jneaton922/UnwaryNuc/UnwaryNuc.kicad_pcb

## KiCad design UnwaryNuc.kicad_pcb (2021-09-27)

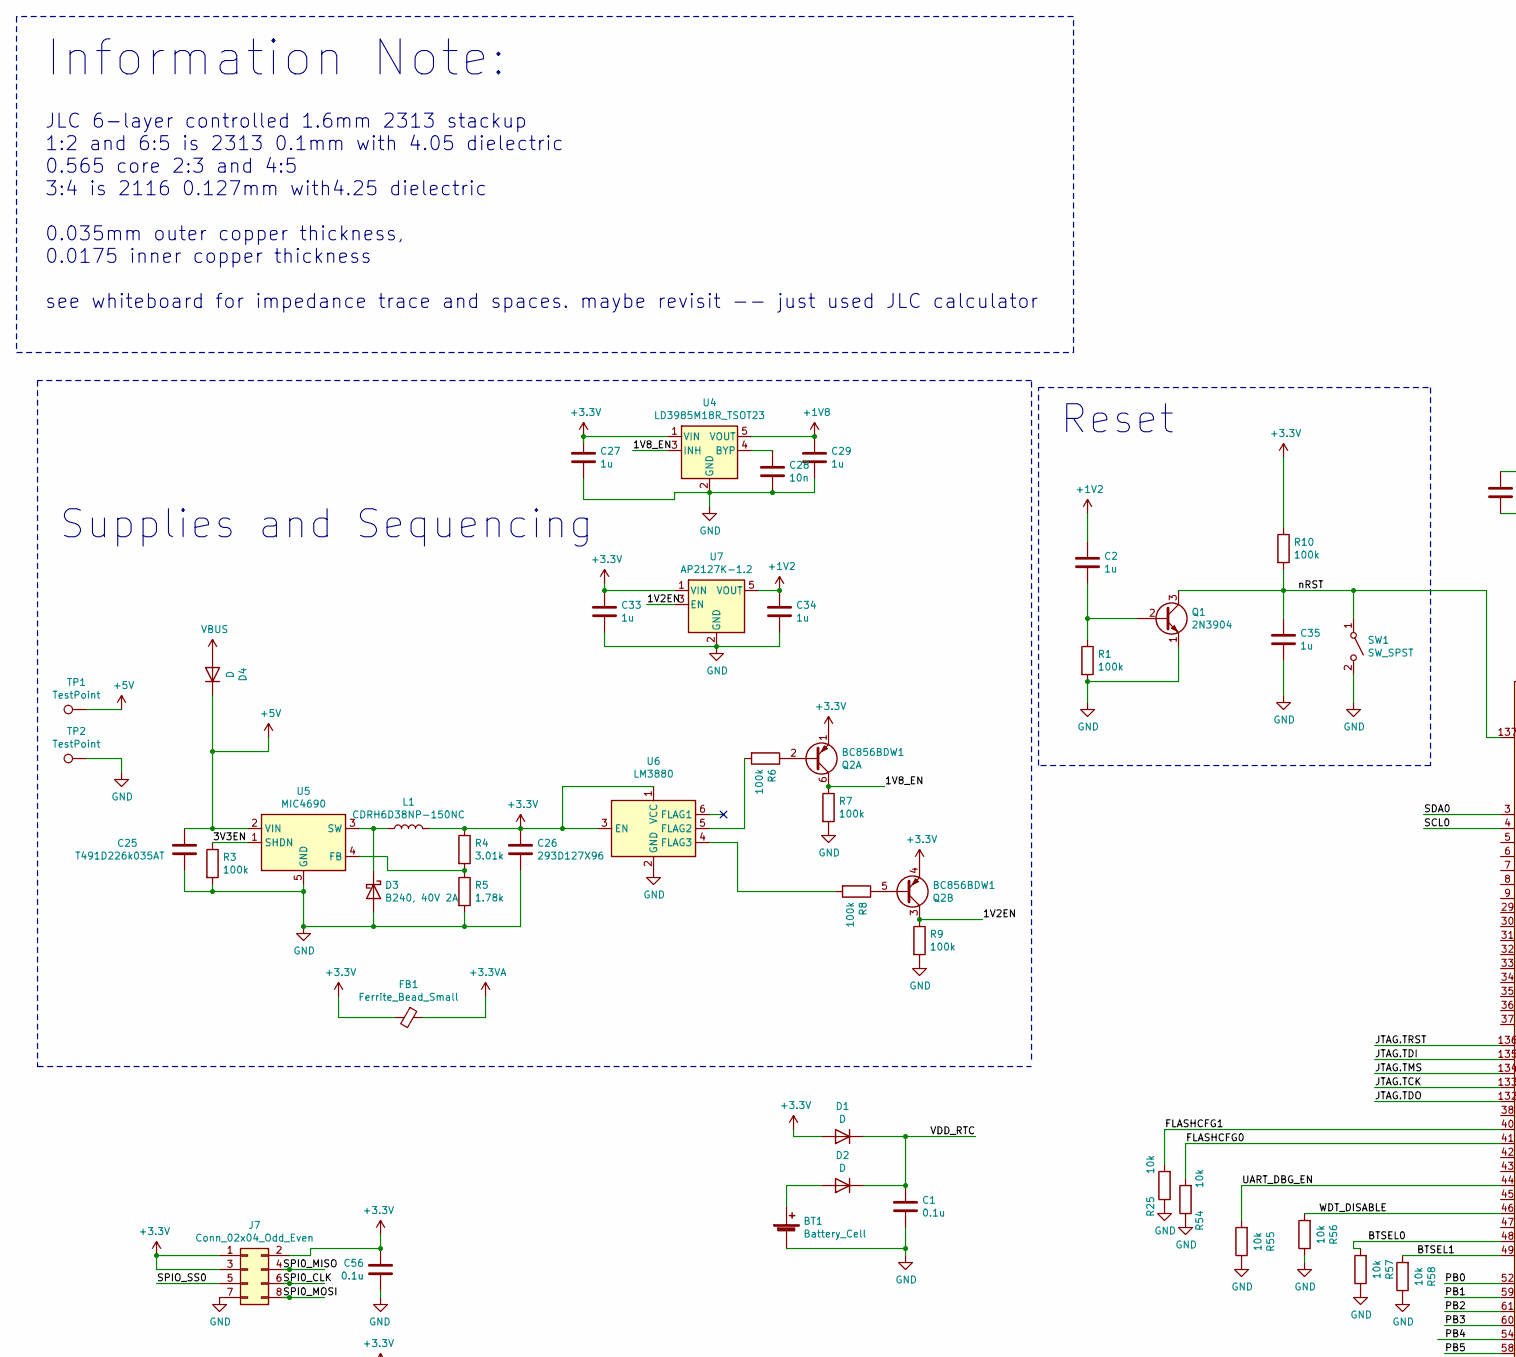
[picture p1: schematic UnwaryNuc.sch, part in row 1, column 1]

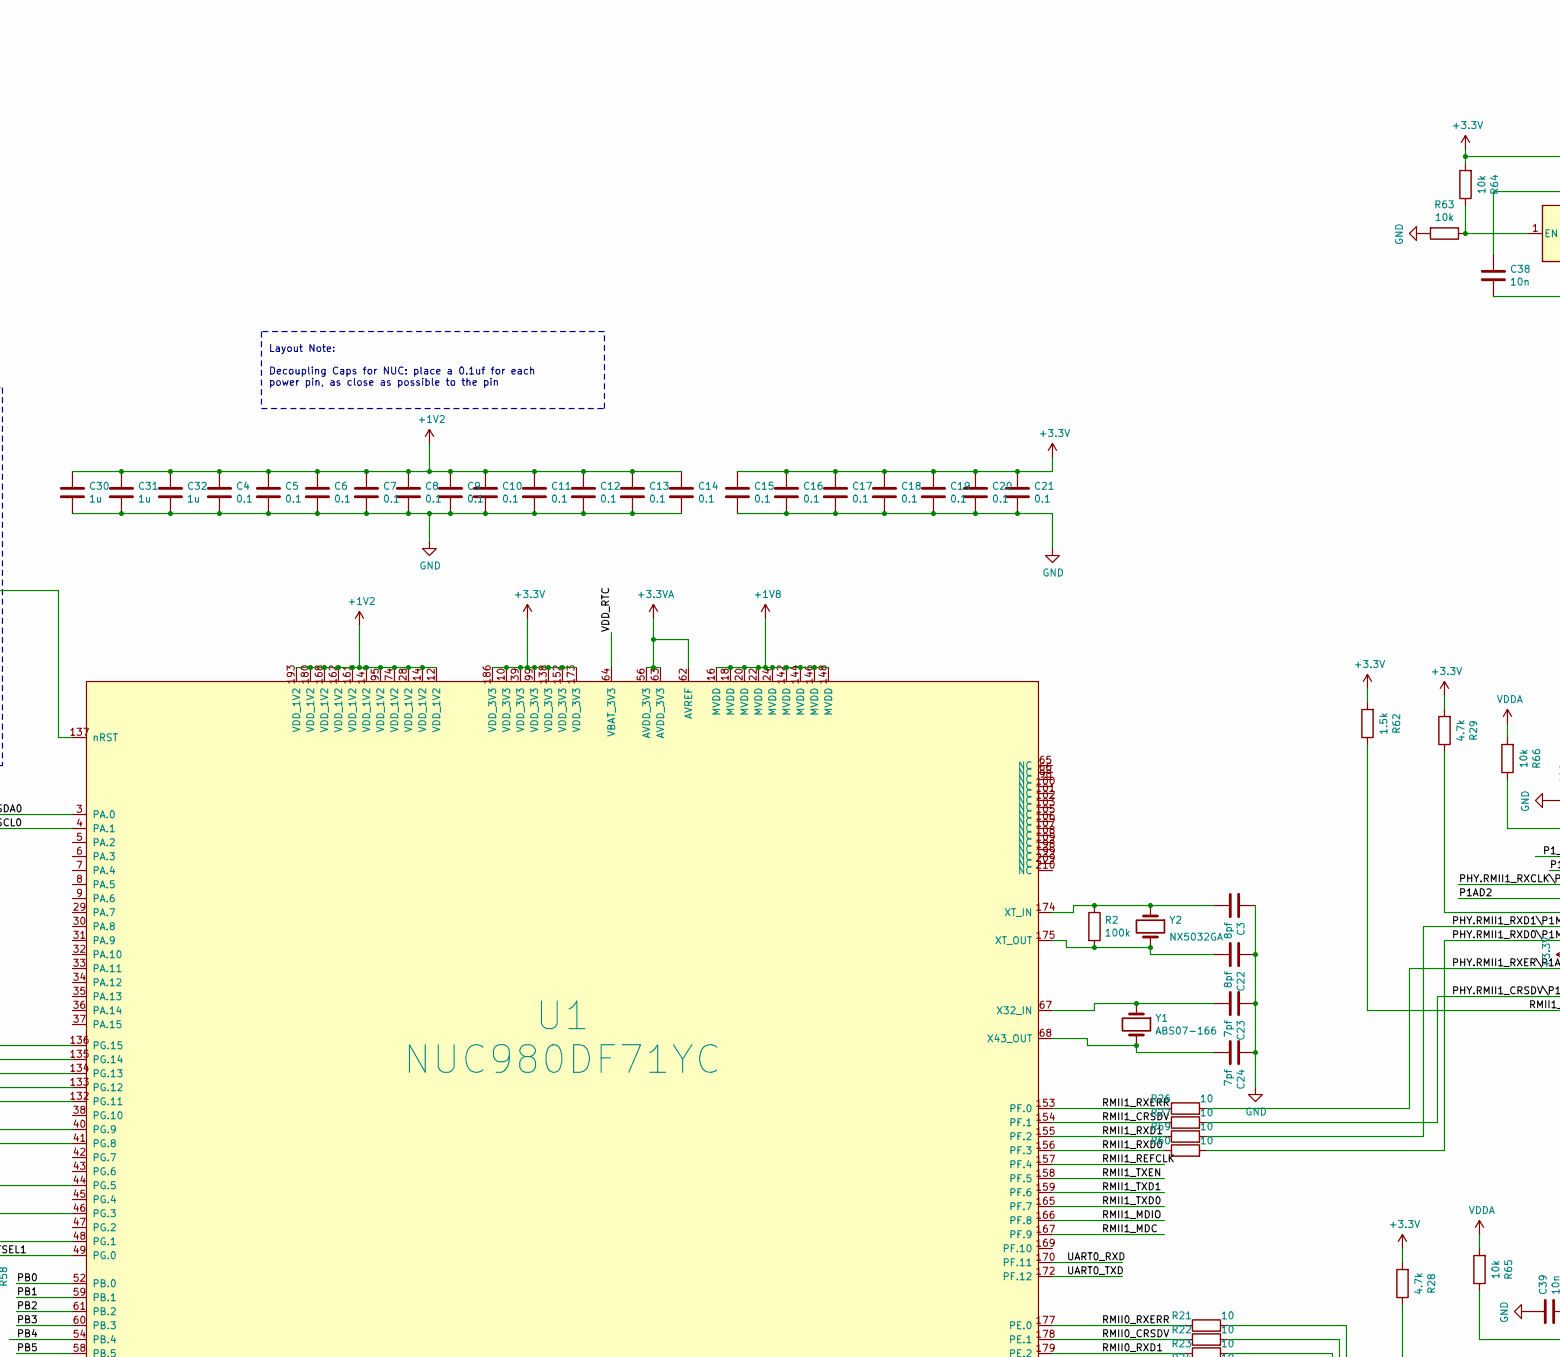
[picture p2: schematic UnwaryNuc.sch, part in row 1, column 2]

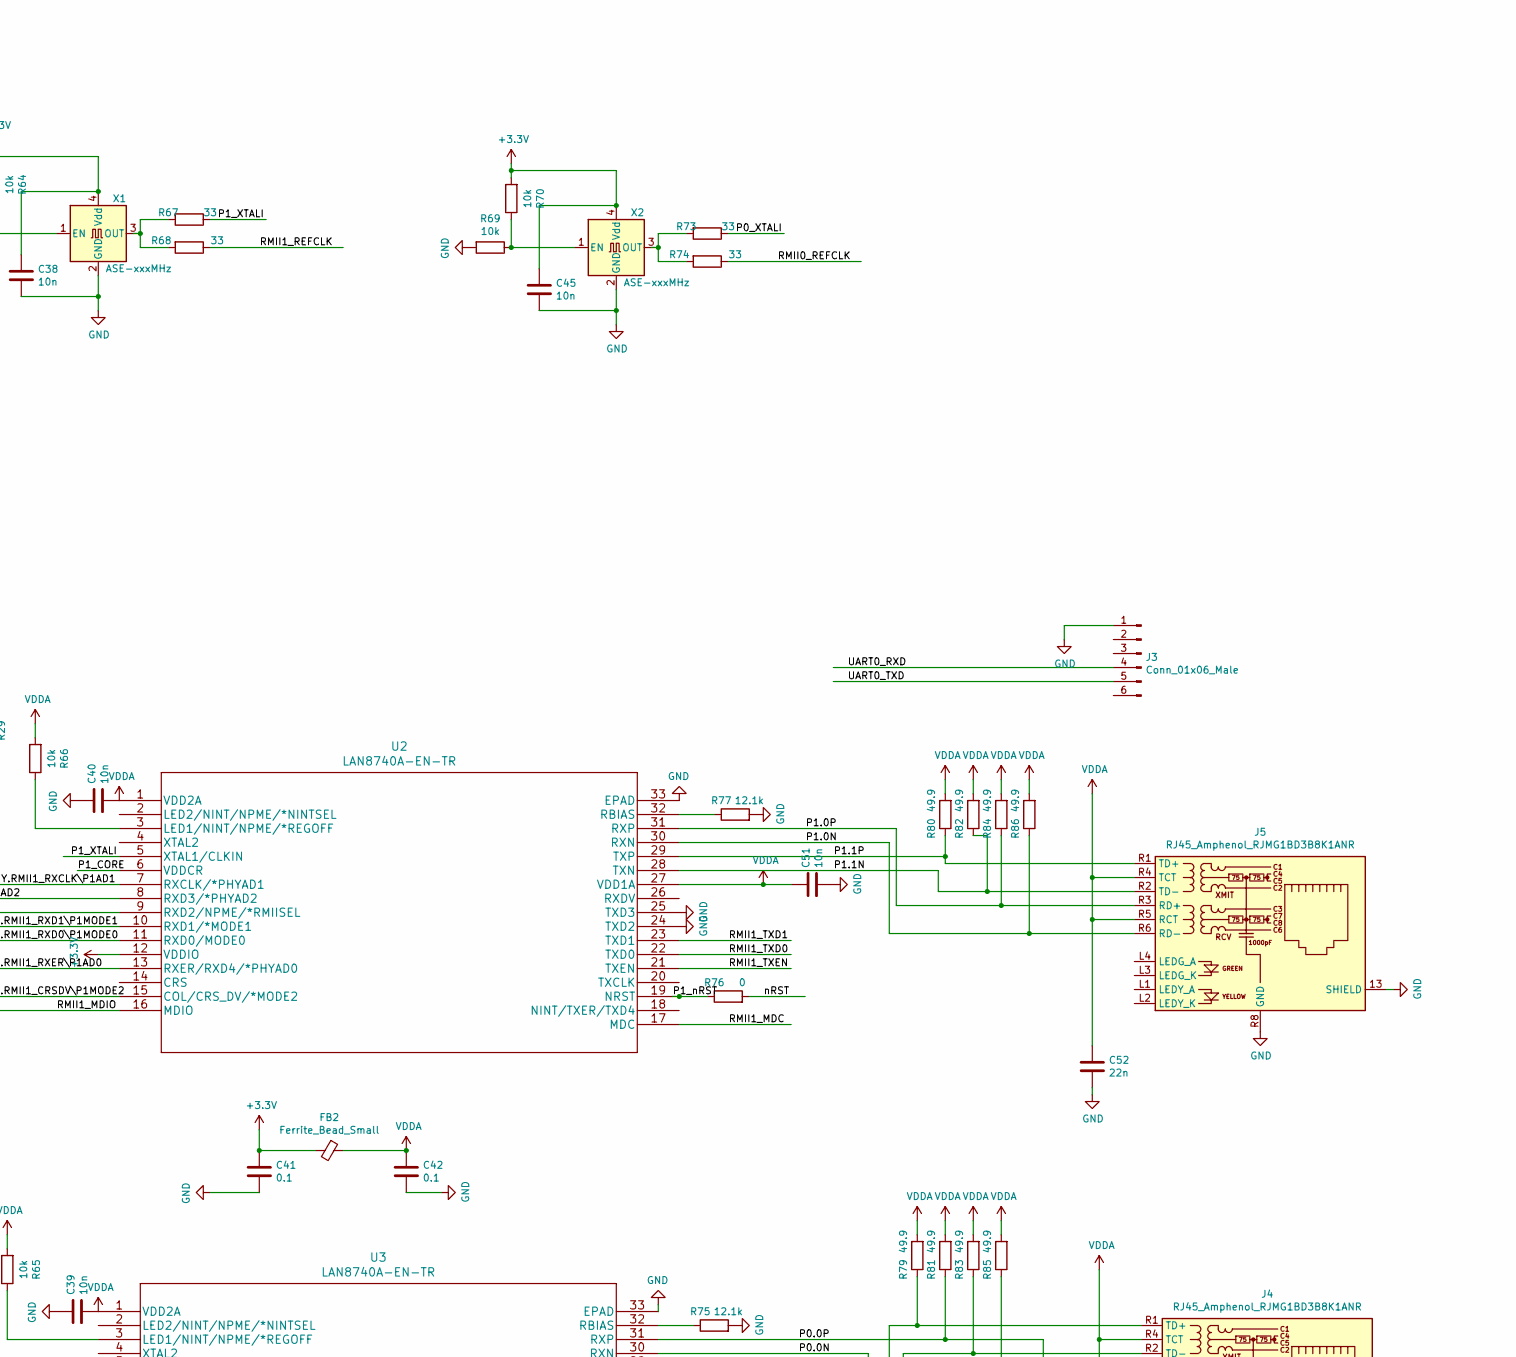
[picture p3: schematic UnwaryNuc.sch, part in row 1, column 3]

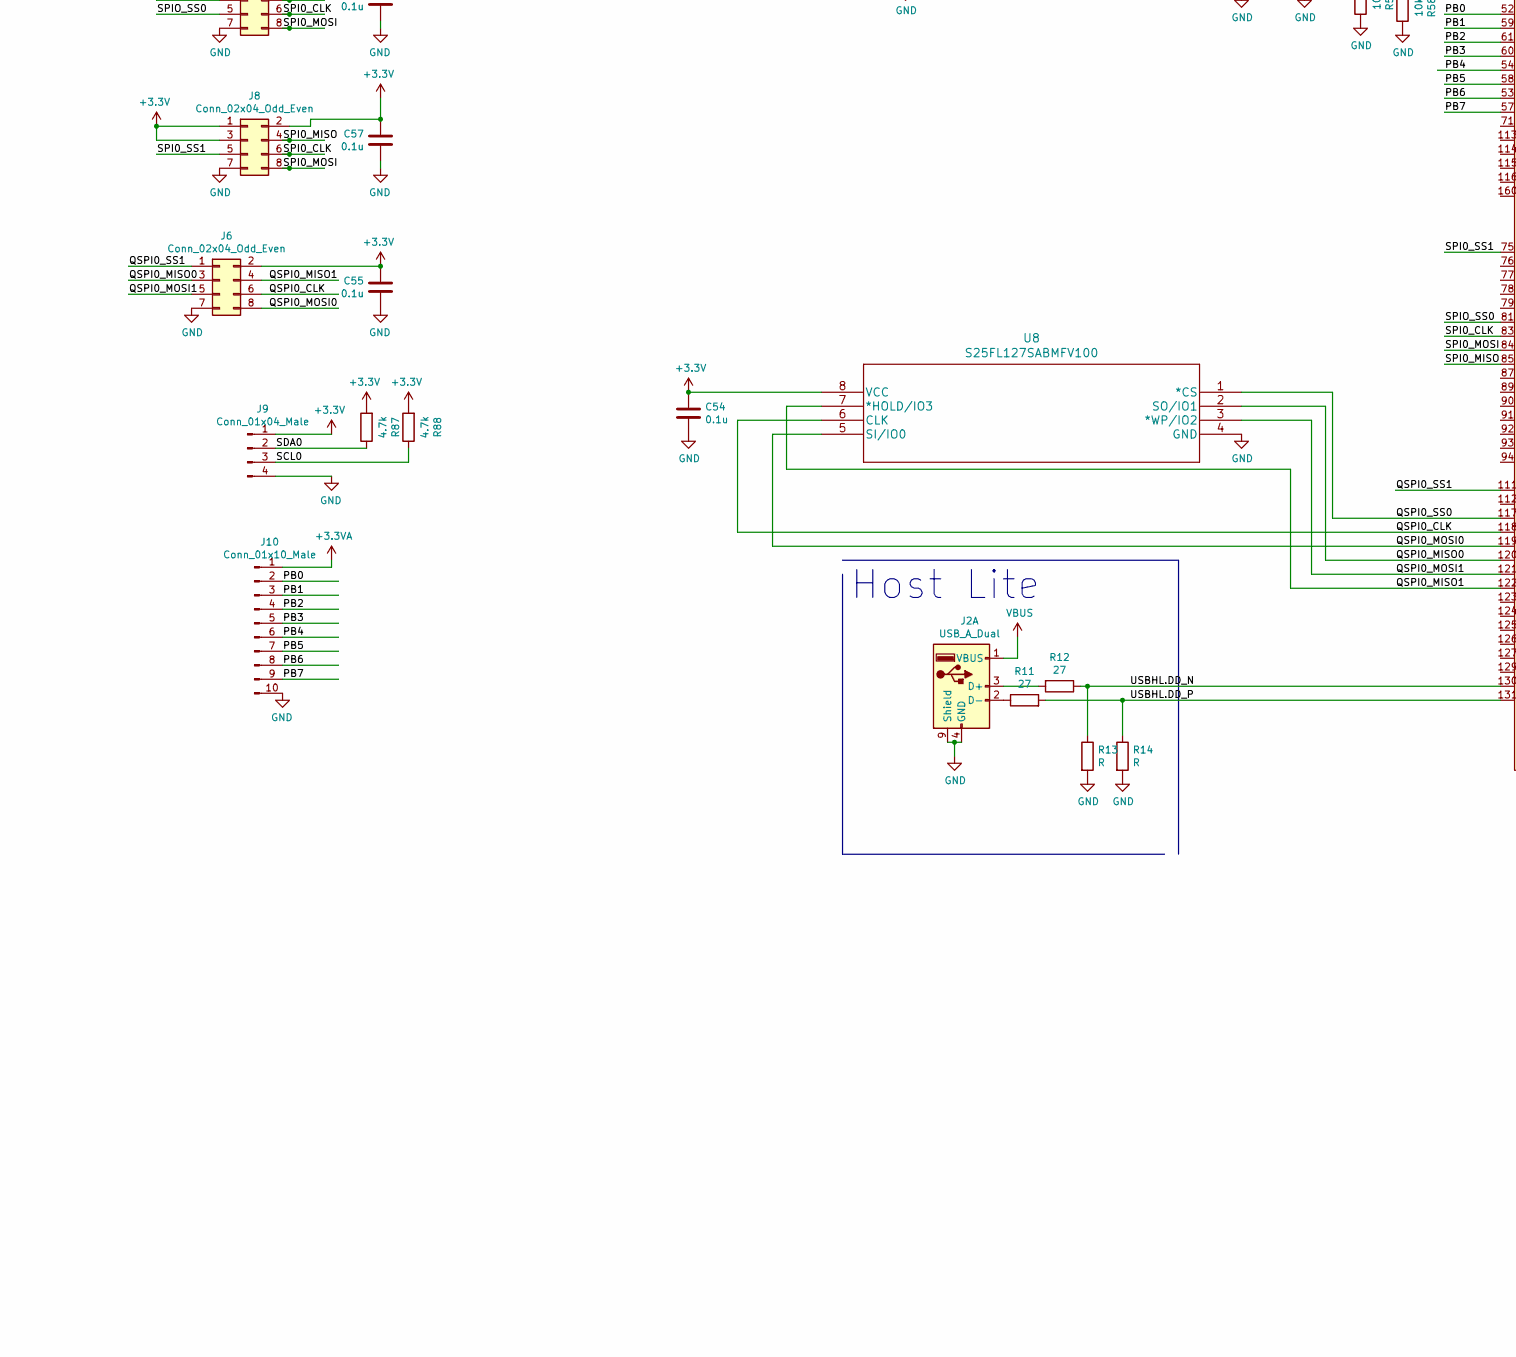
[picture p4: schematic UnwaryNuc.sch, part in row 2, column 1]

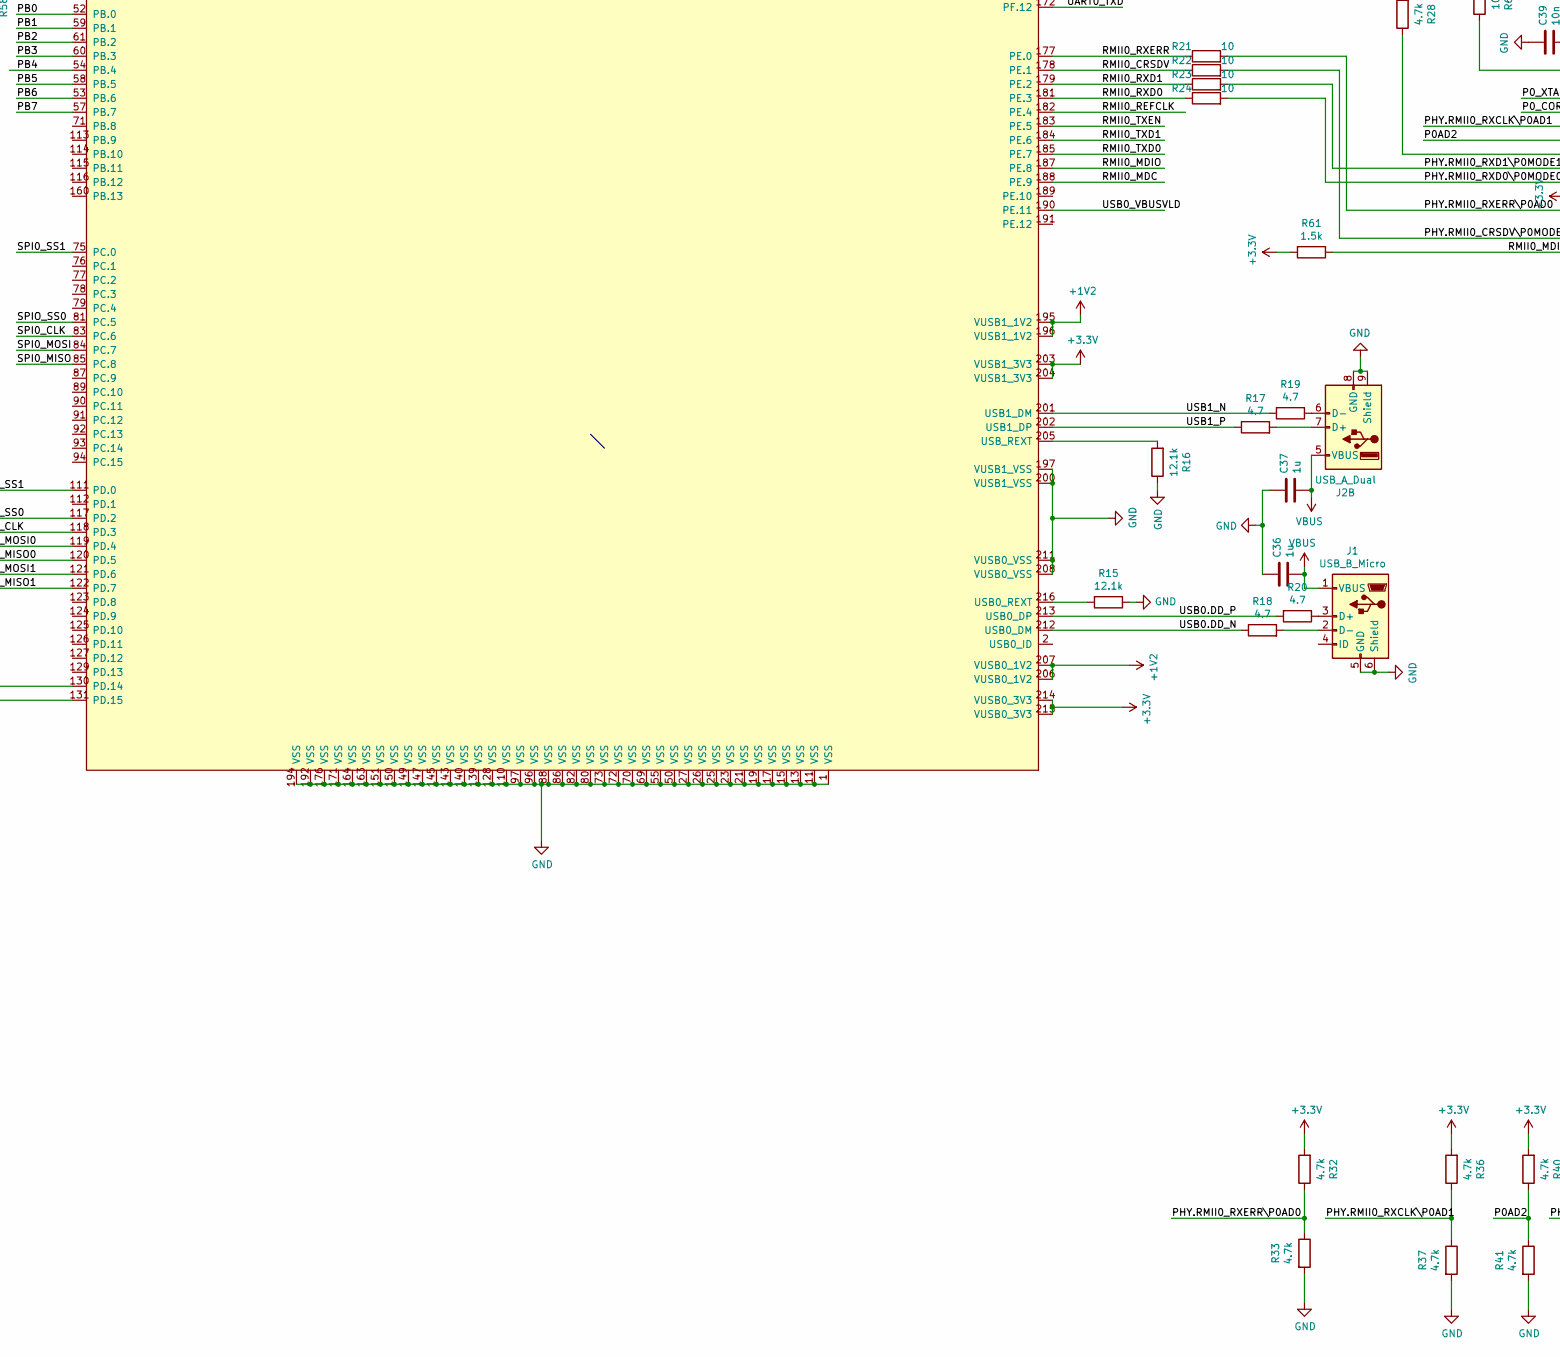
[picture p5: schematic UnwaryNuc.sch, part in row 2, column 2]

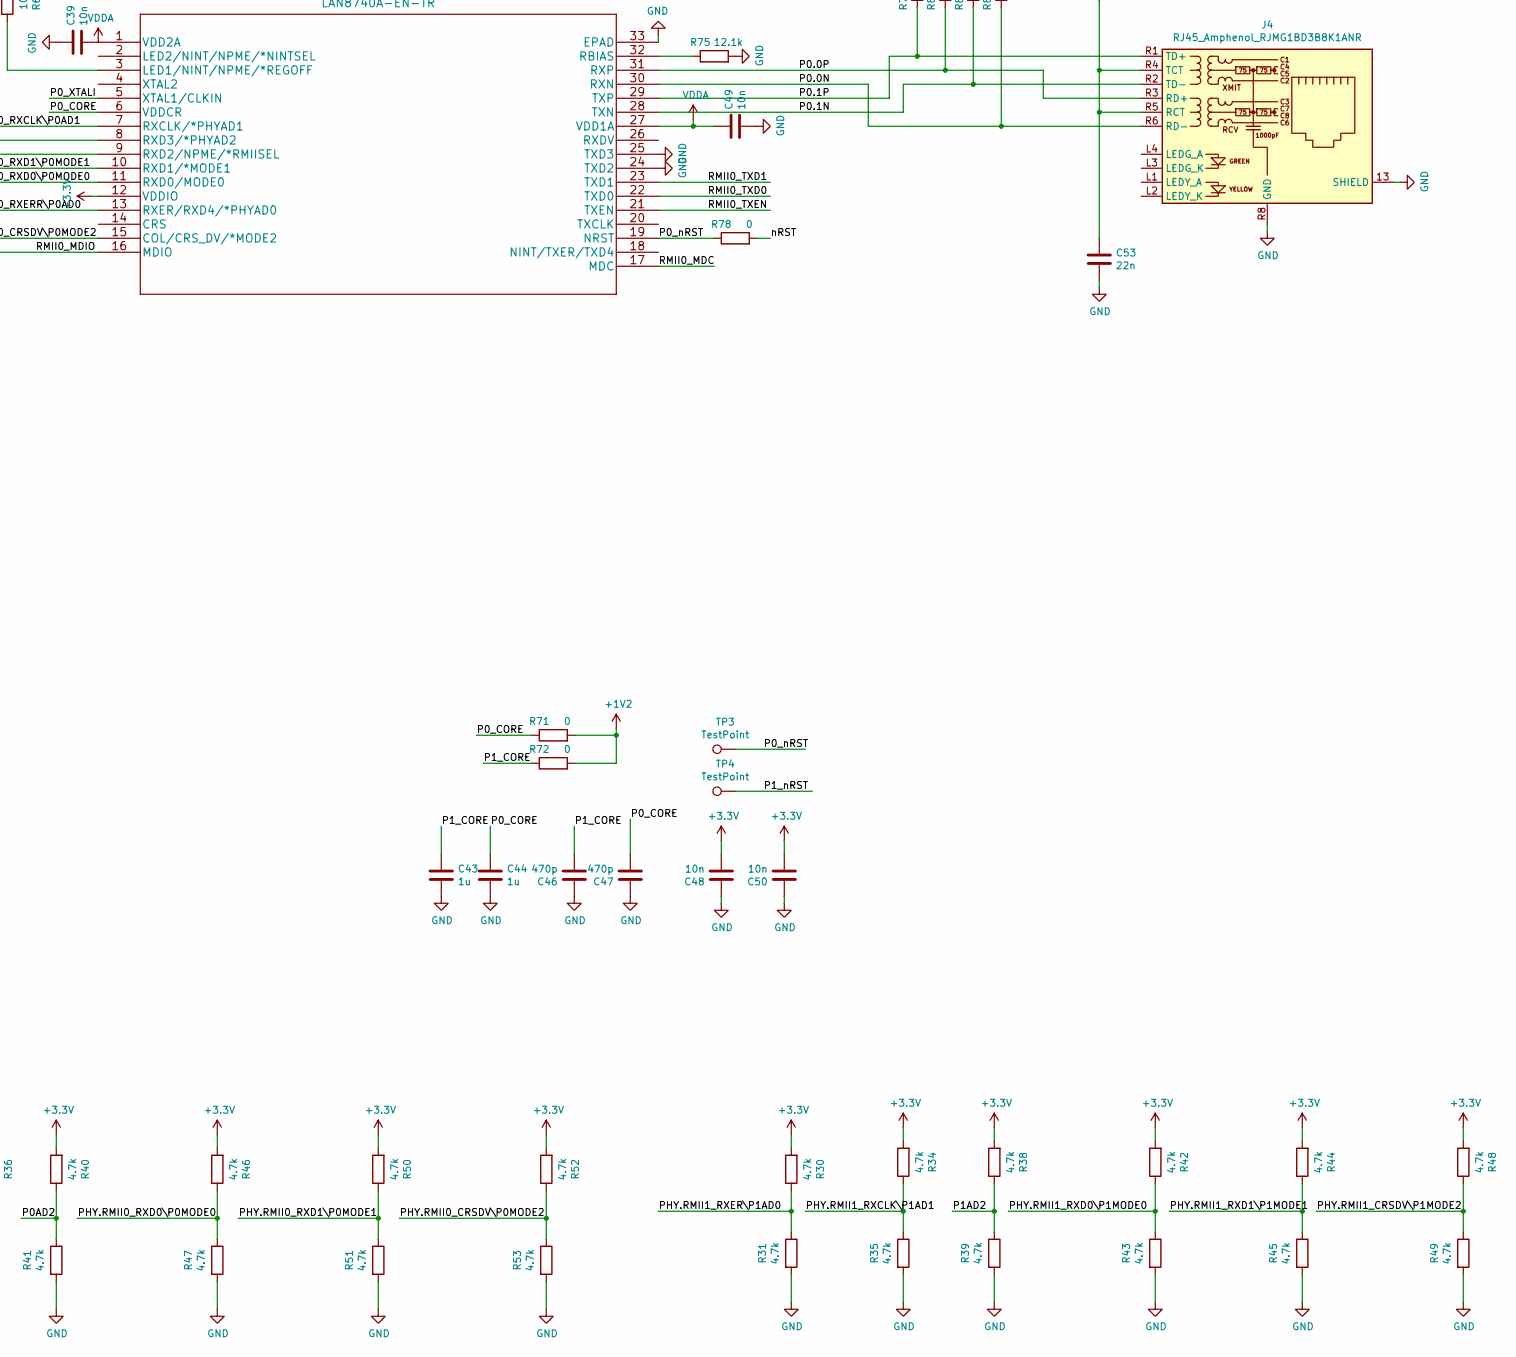
[picture p6: schematic UnwaryNuc.sch, part in row 2, column 3]

Parts:
BT1: Battery_Cell; Battery_Panasonic_CR2032-VS1N_Vertical_CircularHoles
C1, C54, C55, C56, C57: 0.1u; C_1206_3216Metric_Pad1.33x1.80mm_HandSolder
C2, C27, C29, C30, C31, C32, C33, C34, C35, C36, C37, C43, C44: 1u; C_1206_3216Metric_Pad1.33x1.80mm_HandSolder
C3, C22: 8pf; C_0603_1608Metric_Pad1.08x0.95mm_HandSolder
C4, C5, C6, C7, C8, C9, C10, C11, C12, C13, C14, C15, C16, C17, C18, C19, C20, C21, C41, C42: 0.1; C_1206_3216Metric_Pad1.33x1.80mm_HandSolder
C23, C24: 7pf; C_0603_1608Metric_Pad1.08x0.95mm_HandSolder
C25: T491D226k035AT; CP_EIA-7343-15_Kemet-W_Pad2.25x2.55mm_HandSolder
C26: 293D127X96; CP_EIA-7343-43_Kemet-X_Pad2.25x2.55mm_HandSolder
C28: 10n; C_1206_3216Metric_Pad1.33x1.80mm_HandSolder
C38, C39, C40, C45, C48, C49, C50, C51: 10n; C_0603_1608Metric_Pad1.08x0.95mm_HandSolder
C46, C47: 470p; C_0603_1608Metric_Pad1.08x0.95mm_HandSolder
C52, C53: 22n; C_0805_2012Metric_Pad1.18x1.45mm_HandSolder
D1, D2, D4: D; D_SOD-523
D3: B240, 40V 2A; D_SMB_Handsoldering
FB1, FB2: Ferrite_Bead_Small; L_1206_3216Metric_Pad1.42x1.75mm_HandSolder
J1: USB_B_Micro; USB_Micro-B_Molex_47346-0001
J2: USB_A_Dual; USB_A_Wuerth_61400826021_Horizontal_Stacked
J3: Conn_01x06_Male; PinHeader_1x06_P2.54mm_Vertical
J4, J5: RJ45_Amphenol_RJMG1BD3B8K1ANR
J6, J7, J8: Conn_02x04_Odd_Even; PinHeader_2x04_P2.54mm_Vertical
J9: Conn_01x04_Male; PinHeader_1x04_P2.54mm_Vertical
J10: Conn_01x10_Male; PinHeader_1x10_P2.54mm_Vertical
L1: CDRH6D38NP-150NC; CDRH6D38_Sumida
Q1: 2N3904; TO-92_Inline
Q2: BC856BDW1; SOT-363_SC-70-6
R1, R2, R3, R6, R7, R8, R9, R10: 100k; R_0805_2012Metric_Pad1.20x1.40mm_HandSolder
R4: 3.01k; R_0805_2012Metric_Pad1.20x1.40mm_HandSolder
R5: 1.78k; R_0805_2012Metric_Pad1.20x1.40mm_HandSolder
R11, R12: 27; R_0603_1608Metric_Pad0.98x0.95mm_HandSolder
R13, R14: R; R_0603_1608Metric_Pad0.98x0.95mm_HandSolder
R15, R16, R75, R77: 12.1k; R_0603_1608Metric_Pad0.98x0.95mm_HandSolder
R17, R18, R19, R20: 4.7; R_0603_1608Metric_Pad0.98x0.95mm_HandSolder
R21, R22, R23, R24, R26, R27, R59, R60: 10; R_0603_1608Metric_Pad0.98x0.95mm_HandSolder
R25, R54, R55, R56, R57, R58, R63, R64, R65, R66, R69, R70: 10k; R_0603_1608Metric_Pad0.98x0.95mm_HandSolder
R28, R29, R30, R31, R32, R33, R34, R35, R36, R37, R38, R39, R40, R41, R42, R43, R44, R45, R46, R47, R48, R49, R50, R51, R52, R53, R87, R88: 4.7k; R_0603_1608Metric_Pad0.98x0.95mm_HandSolder
R61, R62: 1.5k; R_0603_1608Metric_Pad0.98x0.95mm_HandSolder
R67, R68, R73, R74: 33; R_0603_1608Metric_Pad0.98x0.95mm_HandSolder
R71, R72: 0; R_0805_2012Metric_Pad1.20x1.40mm_HandSolder
R76, R78: 0; R_0603_1608Metric_Pad0.98x0.95mm_HandSolder
R79, R80, R81, R82, R83, R84, R85, R86: 49.9; R_0603_1608Metric_Pad0.98x0.95mm_HandSolder
SW1: SW_SPST; SW_SPST_CK_RS282G05A3
TP1, TP2, TP3, TP4: TestPoint; TestPoint_Keystone_5019_Minature
U1: NUC980DF71YC
U2, U3: LAN8740A-EN-TR
U4: LD3985M18R_TSOT23; TSOT-23-5_HandSoldering
U5: MIC4690; SOIC-8_3.9x4.9mm_P1.27mm
U6: LM3880; SOT-23-6
U7: AP2127K-1.2; SOT-23-5
U8: S25FL127SABMFV100
X1, X2: ASE-xxxMHz; Oscillator_SMD_Abracon_ASE-4Pin_3.2x2.5mm
Y1: ABS07-166; Crystal_SMD_3215-2Pin_3.2x1.5mm
Y2: NX5032GA; Crystal_SMD_5032-2Pin_5.0x3.2mm_HandSoldering

Connections:
+1V2: C2.1, C4.1, C5.1, C6.1, C7.1, C8.1, C9.1, C10.1, C11.1, C12.1, C13.1, C14.1, C30.1, C31.1, C32.1, C34.1, R71.2, R72.2, U1.12 (VDD_1V2), U1.14 (VDD_1V2), U1.28 (VDD_1V2), U1.74 (VDD_1V2), U1.95 (VDD_1V2), U1.141 (VDD_1V2), U1.161 (VDD_1V2), U1.162 (VDD_1V2), U1.168 (VDD_1V2), U1.180 (VDD_1V2), U1.193 (VDD_1V2), U1.195 (VUSB1_1V2), U1.196 (VUSB1_1V2), U1.206 (VUSB0_1V2), U1.207 (VUSB0_1V2), U7.5 (VOUT)
+1V8: C29.1, U1.16 (MVDD), U1.18 (MVDD), U1.20 (MVDD), U1.22 (MVDD), U1.24 (MVDD), U1.142 (MVDD), U1.144 (MVDD), U1.146 (MVDD), U1.148 (MVDD), U4.5 (VOUT)
+3.3VA: FB1.1, J10.1, U1.56 (AVDD_3V3), U1.62 (AVREF), U1.63 (AVDD_3V3)
+3V3: C15.1, C16.1, C17.1, C18.1, C19.1, C20.1, C21.1, C26.1, C27.1, C33.1, C38.1, C41.1, C45.1, C48.2, C50.2, C54.1, C55.1, C56.1, C57.1, D1.2 (A), FB1.2, FB2.2, J6.2, J7.1, J7.2, J7.3, J8.1, J8.2, J8.3, J9.1, L1.2, Q2.1 (E1), Q2.4 (E2), R4.1, R10.1, R28.2, R29.2, R30.2, R32.2, R34.2, R36.2, R38.2, R40.2, R42.2, R44.2, R46.2, R48.2, R50.2, R52.2, R61.2, R62.2, R64.2, R70.2, R87.2, R88.2, U1.10 (VDD_3V3), U1.39 (VDD_3V3), U1.99 (VDD_3V3), U1.138 (VDD_3V3), U1.152 (VDD_3V3), U1.173 (VDD_3V3), U1.186 (VDD_3V3), U1.203 (VUSB1_3V3), U1.204 (VUSB1_3V3), U1.214 (VUSB0_3V3), U1.215 (VUSB0_3V3), U2.12 (VDDIO), U3.12 (VDDIO), U4.1 (VIN), U6.1 (VCC), U6.3 (EN), U7.1 (VIN), U8.8 (VCC), X1.4 (Vdd), X2.4 (Vdd)
+5V: C25.1, D4.1 (K), TP1.1, U5.2 (VIN)
/1V2EN: Q2.3 (C2), R9.1, U7.3 (EN)
/1V8_EN: Q2.6 (C1), R7.1, U4.3 (INH)
/3V3EN: R3.1, U5.1 (SHDN)
/BTSEL0: R57.2, U1.48 (PG.1)
/BTSEL1: R58.2, U1.49 (PG.0)
/FLASHCFG0: R54.2, U1.41 (PG.8)
/FLASHCFG1: R25.2, U1.40 (PG.9)
/JTAG.TCK: U1.133 (PG.12)
/JTAG.TDI: U1.135 (PG.14)
/JTAG.TDO: U1.132 (PG.11)
/JTAG.TMS: U1.134 (PG.13)
/JTAG.TRST: U1.136 (PG.15)
/P0.0N: J4.R6 (RD-), R85.1, U3.30 (RXN)
/P0.0P: J4.R3 (RD+), R81.1, U3.31 (RXP)
/P0.1N: J4.R2 (TD-), R83.1, U3.28 (TXN)
/P0.1P: J4.R1 (TD+), R79.1, U3.29 (TXP)
/P0AD2: R40.1, R41.1, U3.8 (RXD3/*PHYAD2)
/P0_CORE: C44.1, C47.2, R71.1, U3.6 (VDDCR)
/P0_XTALI: R73.1, U3.5 (XTAL1/CLKIN)
/P0_nRST: R78.1, TP3.1, U3.19 (NRST)
/P1.0N: J5.R6 (RD-), R86.1, U2.30 (RXN)
/P1.0P: J5.R3 (RD+), R84.1, U2.31 (RXP)
/P1.1N: J5.R2 (TD-), R82.1, U2.28 (TXN)
/P1.1P: J5.R1 (TD+), R80.1, U2.29 (TXP)
/P1AD2: R38.1, R39.1, U2.8 (RXD3/*PHYAD2)
/P1_CORE: C43.1, C46.2, R72.1, U2.6 (VDDCR)
/P1_XTALI: R67.1, U2.5 (XTAL1/CLKIN)
/P1_nRST: R76.1, TP4.1, U2.19 (NRST)
/PB0: J10.2, U1.52 (PB.0)
/PB1: J10.3, U1.59 (PB.1)
/PB2: J10.4, U1.61 (PB.2)
/PB3: J10.5, U1.60 (PB.3)
/PB4: J10.6, U1.54 (PB.4)
/PB5: J10.7, U1.58 (PB.5)
/PB6: J10.8, U1.53 (PB.6)
/PB7: J10.9, U1.57 (PB.7)
/PHY.RMII0_CRSDV\P0MODE2: R22.2, R52.1, R53.1, U3.15 (COL/CRS_DV/*MODE2)
/PHY.RMII0_RXCLK\P0AD1: R36.1, R37.1, U3.7 (RXCLK/*PHYAD1)
/PHY.RMII0_RXD0\P0MODE0: R24.2, R46.1, R47.1, U3.11 (RXD0/MODE0)
/PHY.RMII0_RXD1\P0MODE1: R23.2, R50.1, R51.1, U3.10 (RXD1/*MODE1)
/PHY.RMII0_RXERR\P0AD0: R21.2, R32.1, R33.1, U3.13 (RXER/RXD4/*PHYAD0)
/PHY.RMII1_CRSDV\P1MODE2: R27.2, R48.1, R49.1, U2.15 (COL/CRS_DV/*MODE2)
/PHY.RMII1_RXCLK\P1AD1: R34.1, R35.1, U2.7 (RXCLK/*PHYAD1)
/PHY.RMII1_RXD0\P1MODE0: R42.1, R43.1, R60.2, U2.11 (RXD0/MODE0)
/PHY.RMII1_RXD1\P1MODE1: R44.1, R45.1, R59.2, U2.10 (RXD1/*MODE1)
/PHY.RMII1_RXER\P1AD0: R26.2, R30.1, R31.1, U2.13 (RXER/RXD4/*PHYAD0)
/QSPI0_CLK: J6.6, U1.118 (PD.3), U8.6 (CLK)
/QSPI0_MISO0: J6.3, U1.120 (PD.5), U8.2 (SO/IO1)
/QSPI0_MISO1: J6.4, U1.122 (PD.7), U8.7 (*HOLD/IO3)
/QSPI0_MOSI0: J6.8, U1.119 (PD.4), U8.5 (SI/IO0)
/QSPI0_MOSI1: J6.5, U1.121 (PD.6), U8.3 (*WP/IO2)
/QSPI0_SS0: U1.117 (PD.2), U8.1 (*CS)
/QSPI0_SS1: J6.1, U1.111 (PD.0)
/RMII0_CRSDV: R22.1, U1.178 (PE.1)
/RMII0_MDC: U1.188 (PE.9), U3.17 (MDC)
/RMII0_MDIO: R61.1, U1.187 (PE.8), U3.16 (MDIO)
/RMII0_REFCLK: R74.1, U1.182 (PE.4)
/RMII0_RXD0: R24.1, U1.181 (PE.3)
/RMII0_RXD1: R23.1, U1.179 (PE.2)
/RMII0_RXERR: R21.1, U1.177 (PE.0)
/RMII0_TXD0: U1.185 (PE.7), U3.22 (TXD0)
/RMII0_TXD1: U1.184 (PE.6), U3.23 (TXD1)
/RMII0_TXEN: U1.183 (PE.5), U3.21 (TXEN)
/RMII1_CRSDV: R27.1, U1.154 (PF.1)
/RMII1_MDC: U1.167 (PF.9), U2.17 (MDC)
/RMII1_MDIO: R62.1, U1.166 (PF.8), U2.16 (MDIO)
/RMII1_REFCLK: R68.1, U1.157 (PF.4)
/RMII1_RXD0: R60.1, U1.156 (PF.3)
/RMII1_RXD1: R59.1, U1.155 (PF.2)
/RMII1_RXERR: R26.1, U1.153 (PF.0)
/RMII1_TXD0: U1.165 (PF.7), U2.22 (TXD0)
/RMII1_TXD1: U1.159 (PF.6), U2.23 (TXD1)
/RMII1_TXEN: U1.158 (PF.5), U2.21 (TXEN)
/SCL0: J9.3, R88.1, U1.4 (PA.1)
/SDA0: J9.2, R87.1, U1.3 (PA.0)
/SPI0_CLK: J7.6, J8.6, U1.83 (PC.6)
/SPI0_MISO: J7.4, J8.4, U1.85 (PC.8)
/SPI0_MOSI: J7.8, J8.8, U1.84 (PC.7)
/SPI0_SS1: J8.5, U1.75 (PC.0)
/SPIO_SS0: J7.5, U1.81 (PC.5)
/UART0_RXD: J3.4, U1.170 (PF.11)
/UART0_TXD: J3.5, U1.172 (PF.12)
/UART_DBG_EN: R55.2, U1.44 (PG.5)
/USB0.DD_N: R18.1, U1.212 (USB0_DM)
/USB0.DD_P: R20.2, U1.213 (USB0_DP)
/USB0_VBUSVLD: U1.190 (PE.11)
/USB1_N: R19.2, U1.201 (USB1_DM)
/USB1_P: R17.1, U1.202 (USB1_DP)
/USBHL.DD_N: R12.1, R13.1, U1.130 (PD.14)
/USBHL.DD_P: R11.2, R14.1, U1.131 (PD.15)
/VDD_RTC: C1.1, D1.1 (K), D2.1 (K), U1.64 (VBAT_3V3)
/WDT_DISABLE: R56.2, U1.46 (PG.3)
/nRST: C35.1, Q1.3 (C), R10.2, R76.2, R78.2, SW1.1 (A), U1.137 (nRST)
GND: BT1.2 (-), C1.2, C3.1, C4.2, C5.2, C6.2, C7.2, C8.2, C9.2, C10.2, C11.2, C12.2, C13.2, C14.2, C15.2, C16.2, C17.2, C18.2, C19.2, C20.2, C21.2, C22.1, C23.1, C24.1, C25.2, C26.2, C27.2, C28.2, C29.2, C30.2, C31.2, C32.2, C33.2, C34.2, C35.2, C36.1, C37.1, C38.2, C39.1, C40.1, C41.2, C42.2, C43.2, C44.2, C45.2, C46.1, C47.1, C48.1, C49.2, C50.1, C51.2, C52.2, C53.2, C54.2, C55.2, C56.2, C57.2, D3.2 (A), J1.5 (GND), J1.6 (Shield), J2.4 (GND), J2.8 (GND), J2.9 (Shield), J3.1, J4.13 (SHIELD), J4.R8 (GND), J5.13 (SHIELD), J5.R8 (GND), J6.7, J7.7, J8.7, J9.4, J10.10, Q1.1 (E), R1.2, R3.2, R5.2, R7.2, R9.2, R13.2, R14.2, R15.1, R16.1, R25.1, R31.2, R33.2, R35.2, R37.2, R39.2, R41.2, R43.2, R45.2, R47.2, R49.2, R51.2, R53.2, R54.1, R55.1, R56.1, R57.1, R58.1, R63.2, R69.2, R75.2, R77.2, SW1.2 (B), TP2.1, U1.1 (VSS), U1.11 (VSS), U1.13 (VSS), U1.15 (VSS), U1.17 (VSS), U1.19 (VSS), U1.21 (VSS), U1.23 (VSS), U1.25 (VSS), U1.26 (VSS), U1.27 (VSS), U1.50 (VSS), U1.55 (VSS), U1.69 (VSS), U1.70 (VSS), U1.72 (VSS), U1.73 (VSS), U1.80 (VSS), U1.82 (VSS), U1.86 (VSS), U1.88 (VSS), U1.96 (VSS), U1.97 (VSS), U1.110 (VSS), U1.128 (VSS), U1.139 (VSS), U1.140 (VSS), U1.143 (VSS), U1.145 (VSS), U1.147 (VSS), U1.149 (VSS), U1.150 (VSS), U1.151 (VSS), U1.163 (VSS), U1.164 (VSS), U1.171 (VSS), U1.176 (VSS), U1.192 (VSS), U1.194 (VSS), U1.197 (VUSB1_VSS), U1.200 (VUSB1_VSS), U1.208 (VUSB0_VSS), U1.211 (VUSB0_VSS), U2.24 (TXD2), U2.25 (TXD3), U2.33 (EPAD), U3.24 (TXD2), U3.25 (TXD3), U3.33 (EPAD), U4.2 (GND), U5.5 (GND), U5.6 (GND), U5.7 (GND), U5.8 (GND), U6.2 (GND), U7.2 (GND), U8.4 (GND), X1.2 (GND), X2.2 (GND)
unnamed: BT1.1 (+), D2.2 (A)
unnamed: C2.2, Q1.2 (B), R1.1
unnamed: C3.2, R2.1, U1.174 (XT_IN), Y2.1
unnamed: C22.2, R2.2, U1.175 (XT_OUT), Y2.2
unnamed: C23.2, U1.67 (X32_IN), Y1.1
unnamed: C24.2, U1.68 (X43_OUT), Y1.2
unnamed: C28.1, U4.4 (BYP)
unnamed: D3.1 (K), L1.1, U5.3 (SW)
unnamed: J1.2 (D-), R18.2
unnamed: J1.3 (D+), R20.1
unnamed: J2.2 (D-), R11.1
unnamed: J2.3 (D+), R12.2
unnamed: J2.6 (D-), R19.1
unnamed: J2.7 (D+), R17.2
unnamed: Q2.2 (B1), R6.1
unnamed: Q2.5 (B2), R8.1
unnamed: R4.2, R5.1, U5.4 (FB)
unnamed: R6.2, U6.5 (FLAG2)
unnamed: R8.2, U6.4 (FLAG3)
unnamed: R15.2, U1.216 (USB0_REXT)
unnamed: R16.2, U1.205 (USB_REXT)
unnamed: R28.1, U3.9 (RXD2/NPME/*RMIISEL)
unnamed: R29.1, U2.9 (RXD2/NPME/*RMIISEL)
unnamed: R63.1, R64.1, X1.1 (EN)
unnamed: R65.1, U3.3 (LED1/NINT/NPME/*REGOFF)
unnamed: R66.1, U2.3 (LED1/NINT/NPME/*REGOFF)
unnamed: R67.2, R68.2, X1.3 (OUT)
unnamed: R69.1, R70.1, X2.1 (EN)
unnamed: R73.2, R74.2, X2.3 (OUT)
unnamed: R75.1, U3.32 (RBIAS)
unnamed: R77.1, U2.32 (RBIAS)
VBUS: C36.2, C37.2, D4.2 (A), J1.1 (VBUS), J2.1 (VBUS), J2.5 (VBUS)
VDDA: C39.2, C40.2, C42.1, C49.1, C51.1, C52.1, C53.1, FB2.1, J4.R4 (TCT), J4.R5 (RCT), J5.R4 (TCT), J5.R5 (RCT), R65.2, R66.2, R79.2, R80.2, R81.2, R82.2, R83.2, R84.2, R85.2, R86.2, U2.1 (VDD2A), U2.27 (VDD1A), U3.1 (VDD2A), U3.27 (VDD1A)

Notes on the sheet:
Information Note:
JLC 6-layer controlled 1.6mm 2313 stackup 1:2 and 6:5 is 2313 0.1mm with 4.05 dielectric 0.565 core 2:3 and 4:5 3:4 is 2116 0.127mm with4.25 dielectric 0.035mm outer copper thickness, 0.0175 inner copper thickness see whiteboard for impedance trace and spaces. maybe revisit -- just used JLC calcula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
Layout Note: Decoupling Caps for NUC: place a 0.1uf for each power pin, as close as possible to the pin
Reset
Supplies and Sequencing
Host Lite

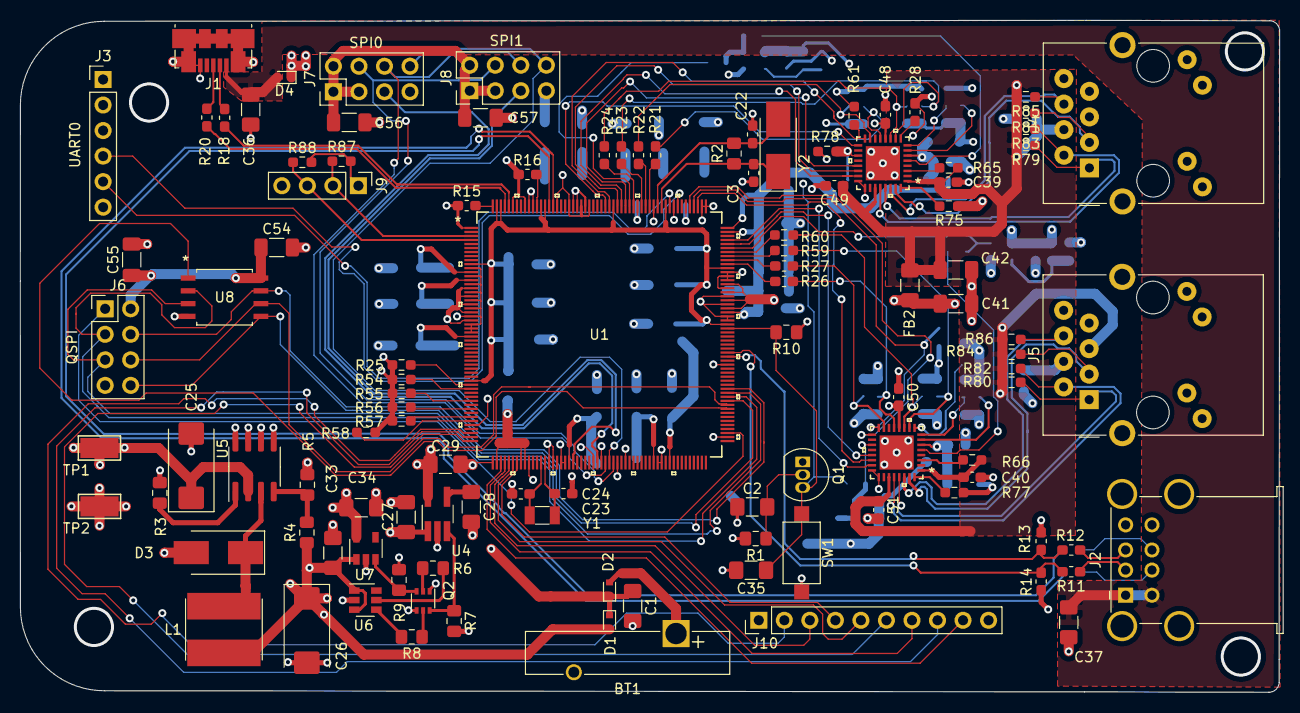
[picture p7: board UnwaryNuc.kicad_pcb from above]

Board: 4 copper layers, 125.3 x 66.8 mm, 182 parts (0 on the bottom side), 126 nets.
