jneaton922/UnwaryNuc/(commit log)

2020-12-30 added some ldos, caps, and reset circuitry.
    [UnwaryNuc.kicad_pcb, UnwaryNuc.sch]
2020-12-31 added supply sequencing and stuff
    [UnwaryNuc.kicad_pcb, UnwaryNuc.sch]
2021-04-28 usb's connected, rmii nets assigned, some placement done
    [UnwaryNuc.kicad_pcb, UnwaryNuc.sch]
2021-06-04 Nuc MAC->PHY->RJ schematic complete, no placement yet
2021-08-02 pushing up to pull to desktop
    [UnwaryNuc.kicad_pcb, UnwaryNuc.sch]
2021-08-02 updating deprecated library footprints. Sch/pcb back in sync on new system
    [UnwaryNuc.kicad_pcb, UnwaryNuc.sch]
2021-08-03 Some rough placement grouping and power routing
    [UnwaryNuc.kicad_pcb, UnwaryNuc.sch]
2021-08-09 added QSPI for boot, routed 1 phy, more placement completed
    [UnwaryNuc.kicad_pcb, UnwaryNuc.sch]
2021-08-09 started other phy
    [UnwaryNuc.kicad_pcb, UnwaryNuc.sch]
2021-08-12 Signal routing pretty much done, working out power distribution. Still could/should add Headers for other I/O, and an ESP backpack or something
    [UnwaryNuc.kicad_pcb, UnwaryNuc.sch]
2021-08-17 finished up some power routing, could still use some cleanup. need to add header for esp and additional GPIO header/expander
    [UnwaryNuc.kicad_pcb]
2021-08-17 added two spi headers, I2C, and a bank of GPIO. placed, still need routed
    [UnwaryNuc.kicad_pcb, UnwaryNuc.sch]
2021-08-18 routed SPI0 and SPI1, cleaned up top silk, added some random mounting holes.
    [UnwaryNuc.kicad_pcb]
2021-08-18 Routed some of PB row, 5 to go.
    [UnwaryNuc.kicad_pcb]
2021-09-27 finished, board as produced
    [UnwaryNuc-B_Mask.gbr, UnwaryNuc-B_Paste.gbr, UnwaryNuc-B_SilkS.gbr, UnwaryNuc-Edge_Cuts.gbr, UnwaryNuc-F_Mask.gbr, UnwaryNuc-F_Paste.gbr, UnwaryNuc-F_SilkS.gbr, UnwaryNuc-L1_(Top).gbr]
